rammp-org/space-bar-push-assist/cad/blender/renders/02_side.png

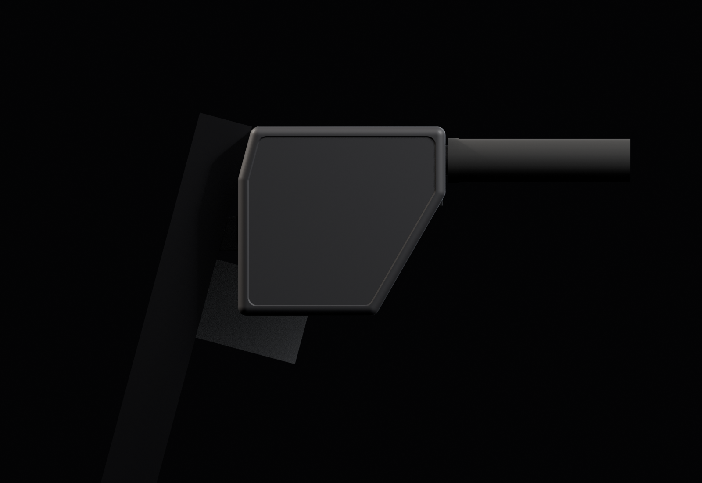
cad/blender/renders/02_side.png
