rammp-org/space-bar-push-assist/cad/blender/renders/03_handle_closeup.png

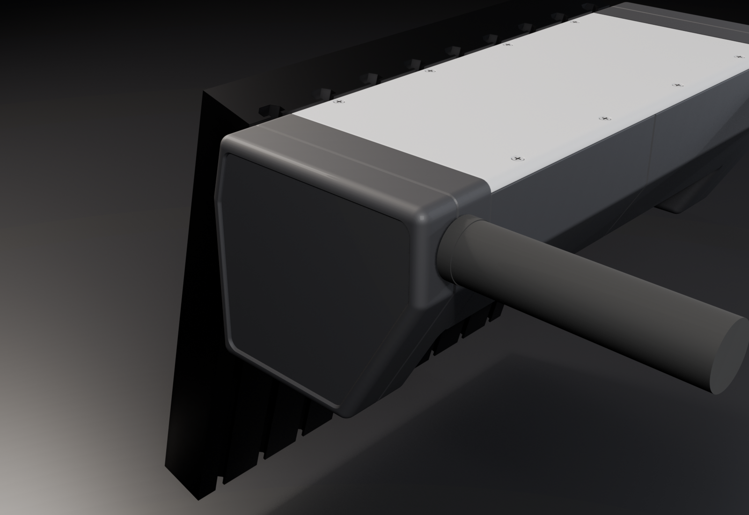
cad/blender/renders/03_handle_closeup.png
