rammp-org/space-bar-push-assist/cad/blender/renders/04_top.png

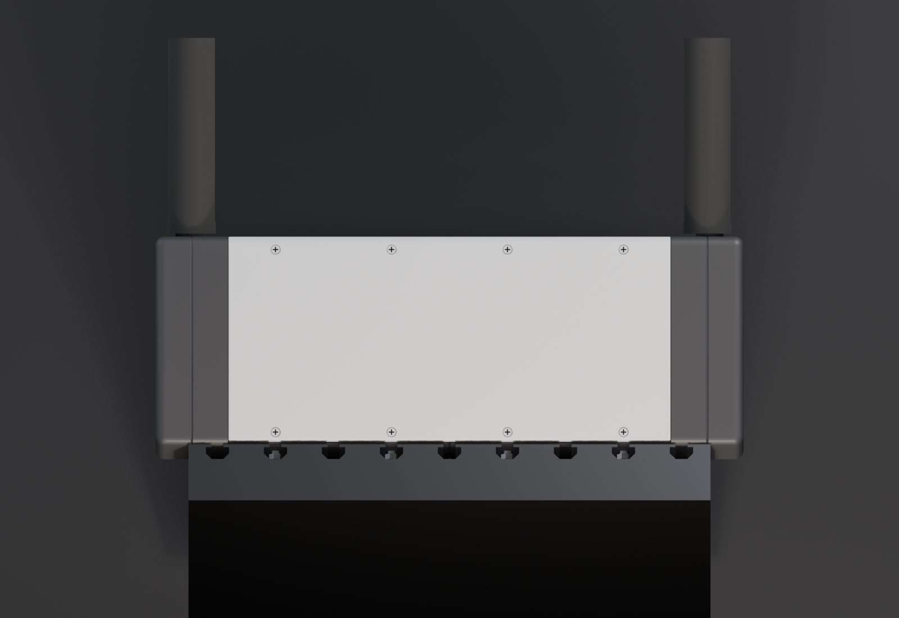
cad/blender/renders/04_top.png
