rammp-org/space-bar-push-assist/cad/blender/renders/05_exploded.png

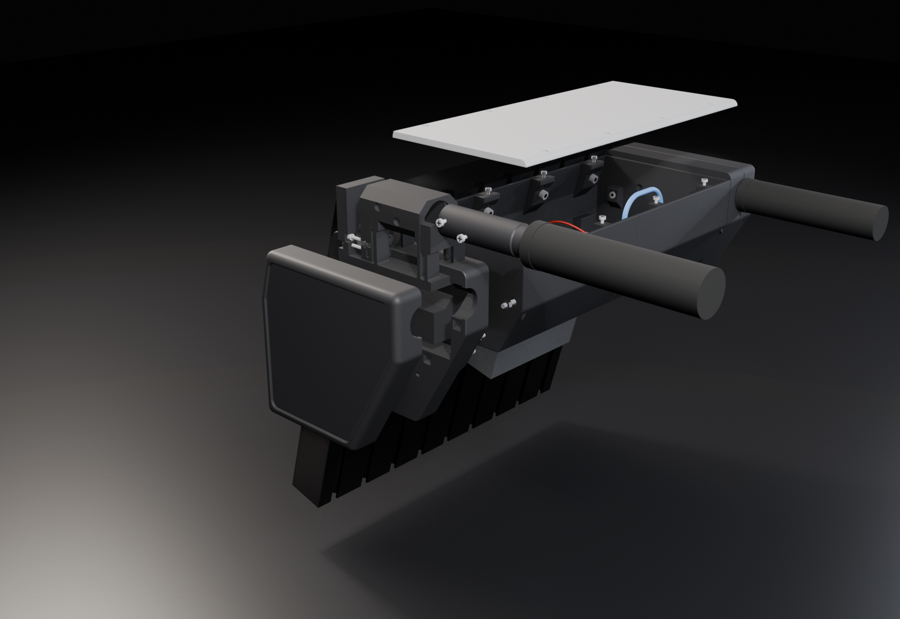
cad/blender/renders/05_exploded.png
