rammp-org/space-bar-push-assist/cad/blender/renders/06_internals.png

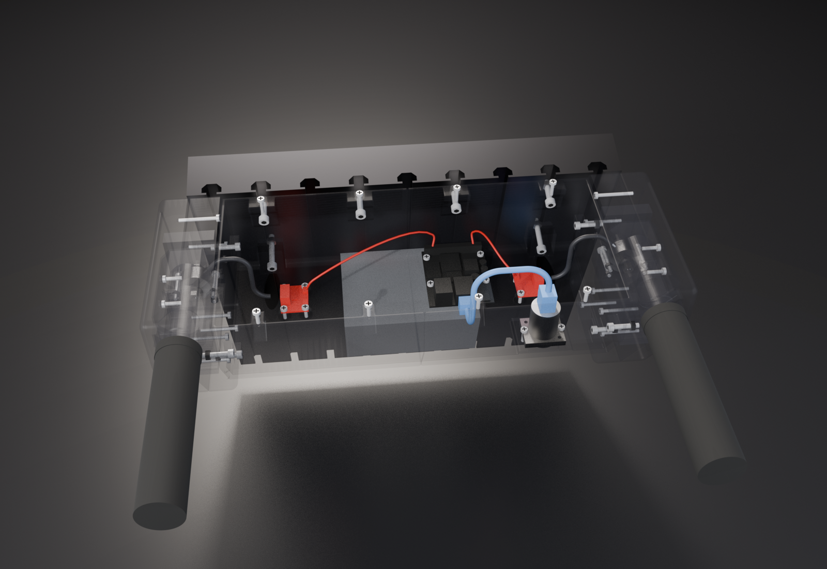
cad/blender/renders/06_internals.png
