rammp-org/space-bar-push-assist/cad/blender/renders/07_lead_side.png

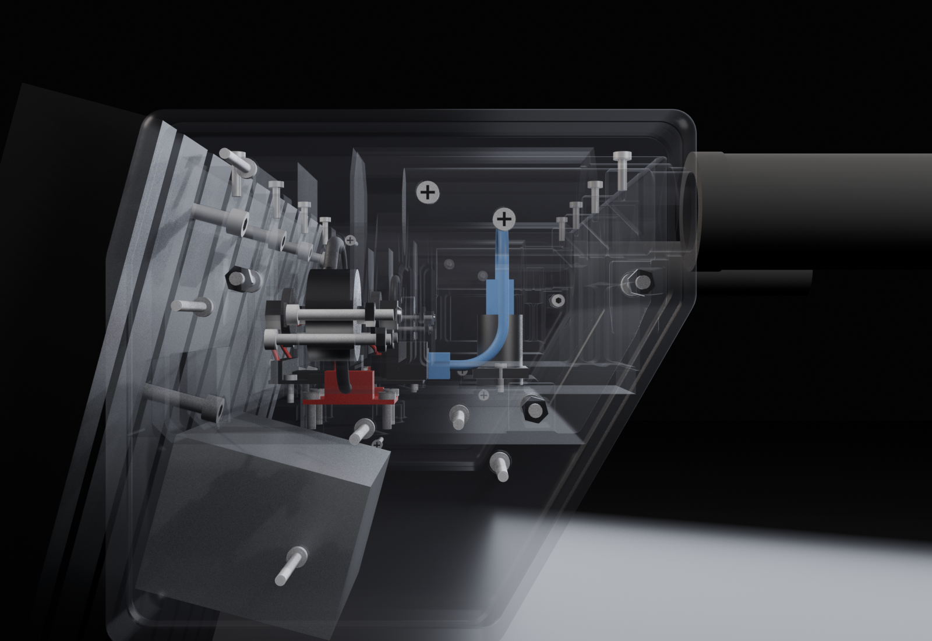
cad/blender/renders/07_lead_side.png
