rammp-org/space-bar-push-assist/cad/profile/profile.png

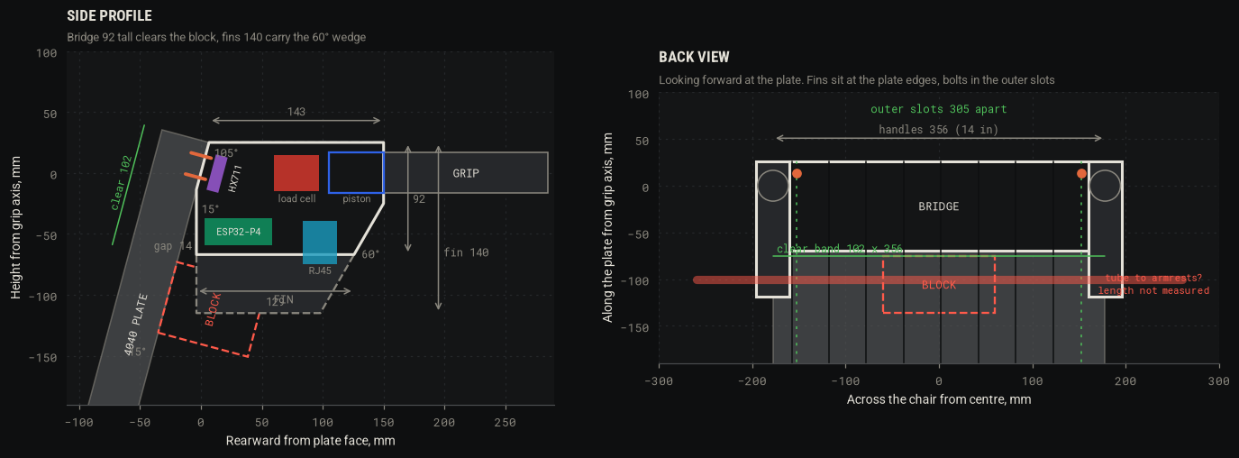
cad/profile/profile.png
