rammp-org/space-bar-push-assist/cad/review/a1/r_left_fin_outboard.png

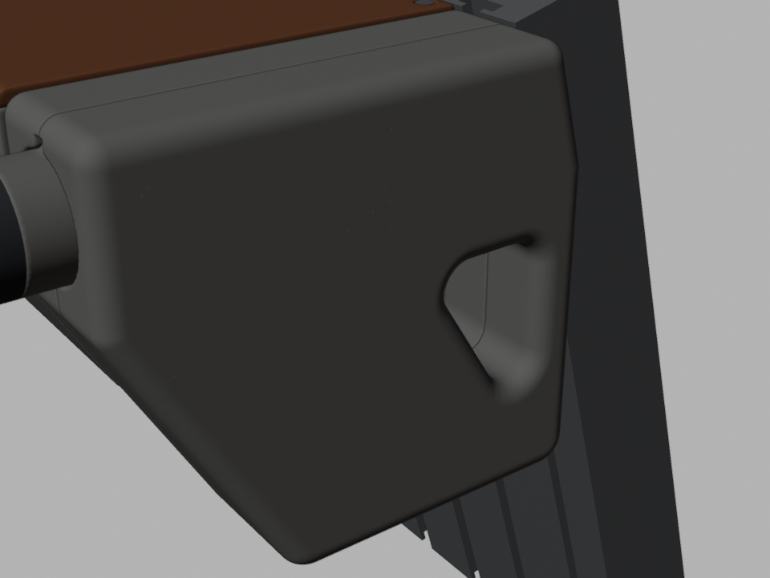
cad/review/a1/r_left_fin_outboard.png
