rammp-org/space-bar-push-assist/cad/review/a1/sec_x125_tray.png

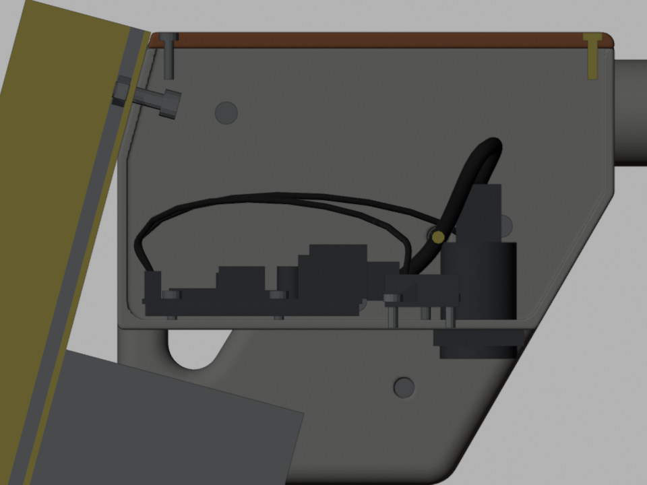
cad/review/a1/sec_x125_tray.png
