rammp-org/space-bar-push-assist/cad/review/a1/sec_x177_head.png

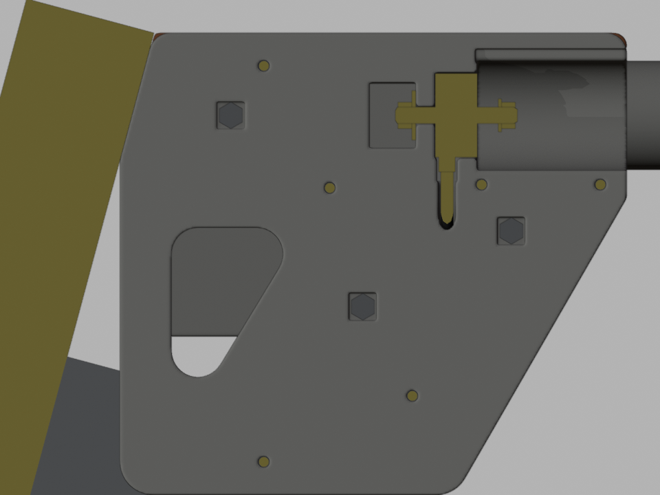
cad/review/a1/sec_x177_head.png
