rammp-org/space-bar-push-assist/cad/review/a2/r_lip_face_R.png

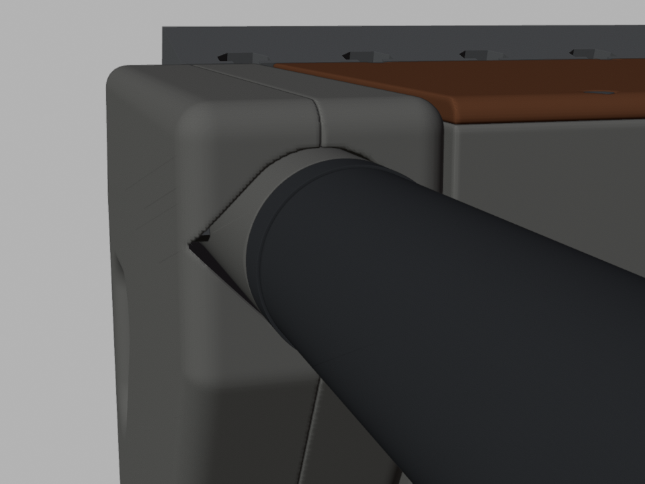
cad/review/a2/r_lip_face_R.png
