rammp-org/space-bar-push-assist/cad/review/a3/sec_x169_post.png

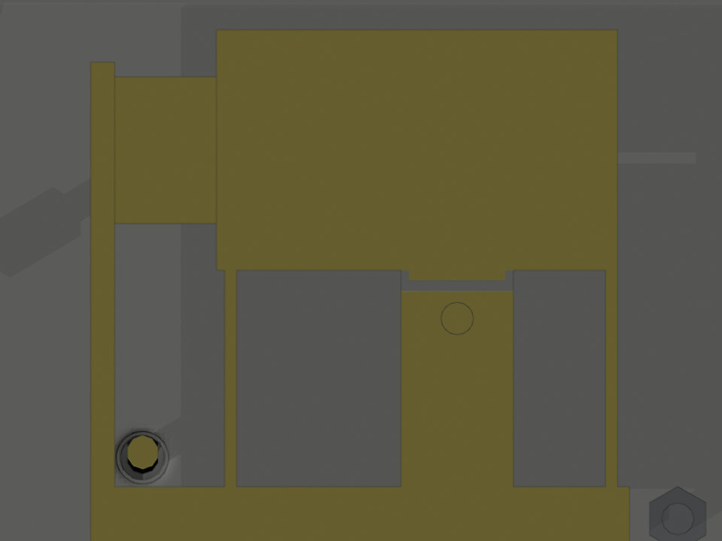
cad/review/a3/sec_x169_post.png
