rammp-org/space-bar-push-assist/cad/review/a3/sec_x177.8_head.png

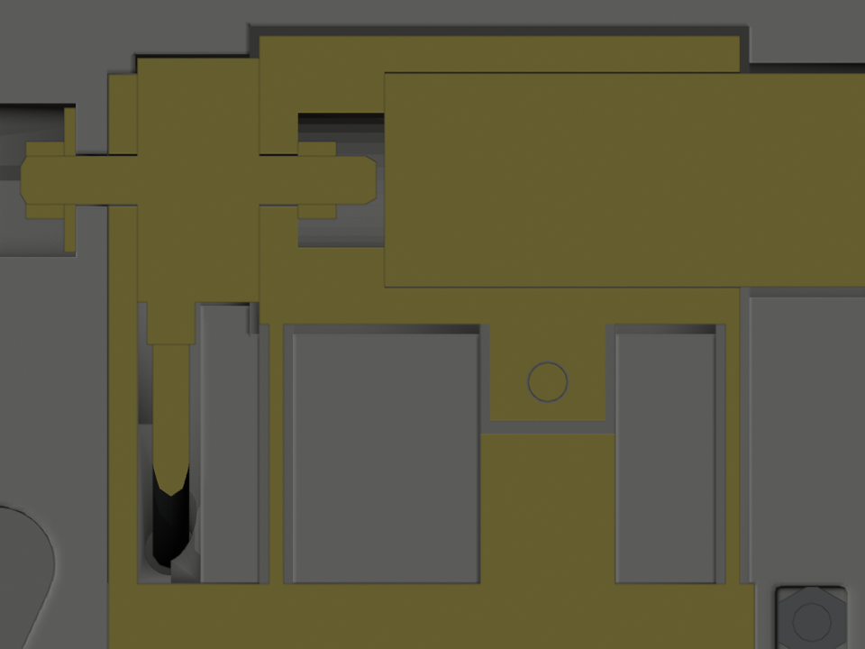
cad/review/a3/sec_x177.8_head.png
