rammp-org/space-bar-push-assist/cad/review/a4_designer/cartridge_R_z013.4_cantilever.png

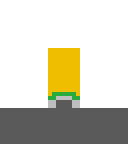
cad/review/a4_designer/cartridge_R_z013.4_cantilever.png
