rammp-org/space-bar-push-assist/cad/review/a4_designer/fin_R_outboard_z018.0_bridge.png

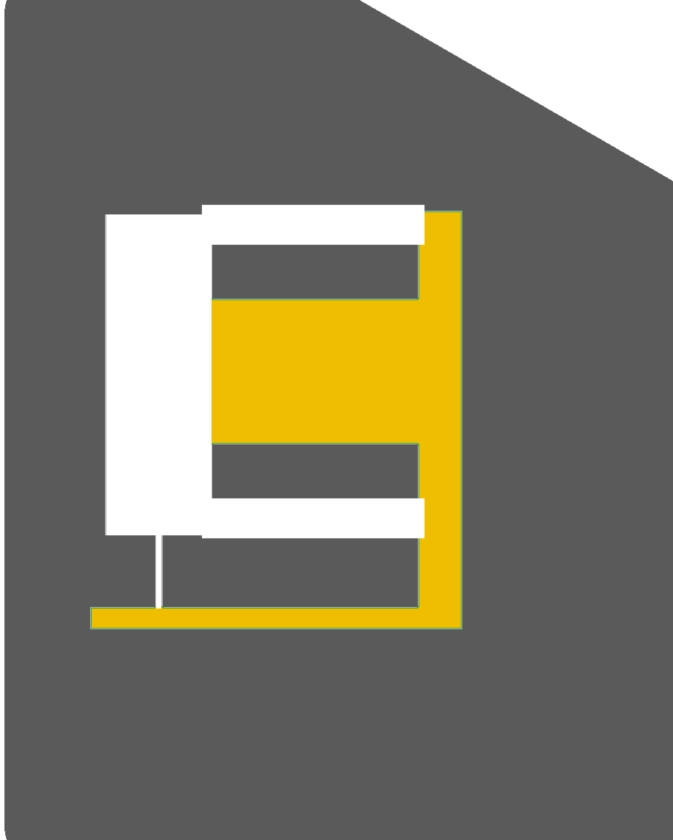
cad/review/a4_designer/fin_R_outboard_z018.0_bridge.png
