rammp-org/space-bar-push-assist/cad/review/a5_designer/fin_R_inboard_z018.0_bridge.png

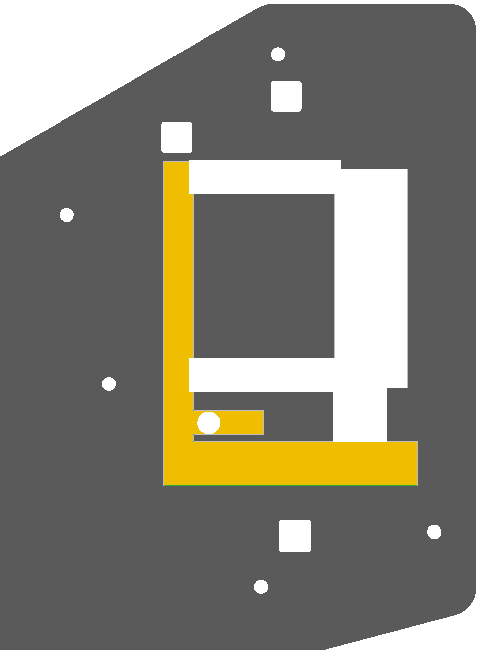
cad/review/a5_designer/fin_R_inboard_z018.0_bridge.png
