rammp-org/space-bar-push-assist/cad/review/a5_designer/fin_R_inboard_z019.0_cantilever.png

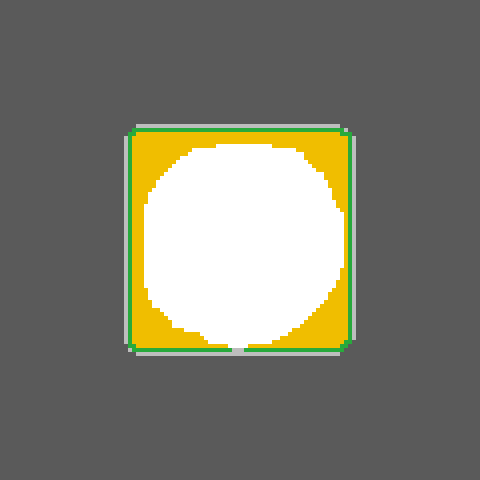
cad/review/a5_designer/fin_R_inboard_z019.0_cantilever.png
