rammp-org/space-bar-push-assist/cad/BOM.md

# Bill of materials

Generated from `cad/blender/manifest.json` by `cad/blender/gen_bom.py`; do not edit by hand.

## Fasteners

| Part | Qty | Model objects | Use |
|---|---|---|---|
| M3 x 10 pan self-tapping | 12 | `FST_Board_screw_0` `FST_Board_screw_1` `FST_Board_screw_10` `FST_Board_screw_11` `FST_Board_screw_2` `FST_Board_screw_3` `FST_Board_screw_4` `FST_Board_screw_5` `FST_Board_screw_6` `FST_Board_screw_7` `FST_Board_screw_8` `FST_Board_screw_9` | ESP32 onto its 6 mm printed standoffs (printed pilots); the two Qwiic Scale amps onto 6 mm drill-to-fit pads (drill the Ø2.5 pilots through the board's holes) |
| M3 x 12 pan self-tapping | 4 | `FST_Cover_screw_L0` `FST_Cover_screw_L2` `FST_Cover_screw_R0` `FST_Cover_screw_R2` | The one cover onto both trays (land boss tops at the front, rear-wall bosses at the rear); it joins the halves |
| M3 x 10 pan self-tapping | 4 | `FST_Cover_screw_L1` `FST_Cover_screw_L3` `FST_Cover_screw_R1` `FST_Cover_screw_R3` | The one cover onto both trays (land boss tops at the front, rear-wall bosses at the rear); it joins the halves |
| M4 x 12 socket head cap (ISO 4762) | 2 | `FST_Jack_lip_screw_a` `FST_Jack_lip_screw_b` | Bench tool: through the cradle's side walls behind the block (the pull reaction) |
| M5 x 35 socket head cap (ISO 4762) | 1 | `FST_Jack_screw` | Bench tool: the cradle's jack, on the grip axis (one set for both cartridges); its head floats 9 mm behind the upright (room for the jack nut and the mass hanger in the known-mass check) |
| M3 x 30 pan self-tapping | 12 | `FST_M3_screw_L0` `FST_M3_screw_L1` `FST_M3_screw_L2` `FST_M3_screw_L3` `FST_M3_screw_L4` `FST_M3_screw_L5` `FST_M3_screw_R0` `FST_M3_screw_R1` `FST_M3_screw_R2` `FST_M3_screw_R3` `FST_M3_screw_R4` `FST_M3_screw_R5` | Fin halves together, from the inboard face into pilots in the outboard half |
| M4 x 20 socket head cap (ISO 4762) | 6 | `FST_M4_screw_L0` `FST_M4_screw_L1` `FST_M4_screw_L2` `FST_M4_screw_R0` `FST_M4_screw_R1` `FST_M4_screw_R2` | Fin to tray end wall, from inside the tray into the fin's captive nuts |
| M5 x 20 socket head cap (ISO 4762) | 4 | `FST_M5_bolt_0` `FST_M5_bolt_1` `FST_M5_bolt_2` `FST_M5_bolt_3` | Unit to the chair plate, into 40-series drop-in T-nuts |
| M5 x 30 socket head cap (ISO 4762) | 2 | `FST_M5_bolt_4` `FST_M5_bolt_5` | Unit to the chair plate, into 40-series drop-in T-nuts |
| M3 x 12 pan self-tapping | 4 | `FST_Piston_screw_L0` `FST_Piston_screw_L1` `FST_Piston_screw_R0` `FST_Piston_screw_R1` | Piston plug into the cartridge socket, from the top link's outboard face |
| M3 x 12 pan self-tapping | 2 | `FST_RJ45_screw_0` `FST_RJ45_screw_1` | RJ45 coupler flange onto its pad in tray L, from above |
| M3 x 30 socket head cap (ISO 4762) | 4 | `FST_Stop_screw_pull_L_in` `FST_Stop_screw_pull_L_out` `FST_Stop_screw_pull_R_in` `FST_Stop_screw_pull_R_out` | Pull overload stop (two per cartridge): from the front through the block into its nut; its head's underside meets the block's front counterbore floor; set per cell in the cradle (README) |
| M3 x 25 socket head cap (ISO 4762) | 4 | `FST_Stop_screw_push_L_in` `FST_Stop_screw_push_L_out` `FST_Stop_screw_push_R_in` `FST_Stop_screw_push_R_out` | Push overload stop, on the cell axis (two per cartridge): goes in sideways with its nut on (after the cell); its head's top face meets a counterbore floor in the block; set per cell in the cradle (README) |
| M4 hex nut | 2 | `FST_Jack_lip_nut_a` `FST_Jack_lip_nut_b` | Bench tool: in pockets on the cradle side walls' inner faces |
| M5 hex nut | 1 | `FST_Jack_nut` | Bench tool: in the cradle's rear upright |
| M5 hex nut (glued on the jack screw tip) | 1 | `FST_Jack_swivel_nut` | Bench tool: superglued on the jack screw's tip, in the setting plug's T-slot |
| M4 hex nut | 6 | `FST_M4_nut_L0` `FST_M4_nut_L1` `FST_M4_nut_L2` `FST_M4_nut_R0` `FST_M4_nut_R1` `FST_M4_nut_R2` | Fin-to-tray nuts, in slots on the inboard half's split face |
| M3 hex nut | 4 | `FST_Stop_nut_pull_L_in` `FST_Stop_nut_pull_L_out` `FST_Stop_nut_pull_R_in` `FST_Stop_nut_pull_R_out` | Pull stop nut, in a slot in the side of the link's drop |
| M3 hex nut | 4 | `FST_Stop_nut_push_L_in` `FST_Stop_nut_push_L_out` `FST_Stop_nut_push_R_in` `FST_Stop_nut_push_R_out` | Push stop nut, in a slot in the side of the link's drop |
| M5 drop-in T-nut, 40 series | 6 | `FST_T-nut_0` `FST_T-nut_1` `FST_T-nut_2` `FST_T-nut_3` `FST_T-nut_4` `FST_T-nut_5` | In the chair plate's slots |

## Load-cell hardware (on the cell studs)

| Part | Qty |
|---|---|
| M5 hex nut (front: on the front stud, on the printed Ø15 washer in the block's front counterbore; 8 mm nut-driver) | 2 |
| M5 hex nut (rear: on the rear stud, on the printed Ø13 washer in the drop's bore; 8 mm nut-driver on the 150 mm extension along the cell axis, between the leaf strips and under the catch saddle, from the cartridge's rear end) | 2 |

Both cell nuts are finger-tight on the bare 8 mm nut-driver bit (about 0.1-0.2 N.m), settled overnight on the bench, re-snugged, then locked with a dab of hot glue, all before the stops are set. The washers are printed (below), 2.4 mm thick: each bridges the 5.5 mm stud slot under its nut (11 MPa at 1.2 x FS pull, row a7R washer); no bought washers.

## Load cell: 20 kg JHD puck (chosen by Alex, 2026-10-27)

**Two 20 kg JHD tension/compression pucks** (Ø25.4 x 12.7 body, M5 studs 12.15 long). The unit is not meant for hard shoves: with the stops at 1.2 x FS a 600 N shove would reach 1.44-1.92 x FS, so keep pushes gentle. The 50 kg puck (same body and studs) drops in with no CAD change if that ever changes. Note the cell's rated output (mV/V) from its label or calibration sheet: the firmware's scale needs it (README).

## Amplifiers: SparkFun Qwiic Scale (NAU7802, SEN-15242), no soldering iron and no blade

Two SparkFun Qwiic Scale boards (a6 review #2: the Adafruit HX711's logic header shipped loose). Nothing on them needs an iron or a small screwdriver: the cell's four wires go into a push-lever spring terminal (press the lever with a fingertip or the tip of a hex key, push the stripped wire in, let go), and the logic side is a Qwiic (JST SH) socket. Per board, one Qwiic-to-female-socket cable (they come long; cut to length) (SparkFun PRT-14988 or Adafruit 4397) to the ESP32 header. The NAU7802 has a fixed I2C address, so the two boards go on the ESP32-P4's two I2C ports. Four Ø3.3 holes on a 17.8 x 25.4 mm pattern (measured on a board). Each amp sits on four 6 mm drill-to-fit pads (Ø10, solid, a centre dimple, no printed pilot). Set the board on them and drill the Ø2.5 pilots through its holes, 9 mm deep; a hole up to 1.5 mm off the modelled pattern still leaves 1.5 mm of wall round the pilot. Then four of the kit's M3 x 10 self-tappers per board.

**ESP32 header: measure before ordering the cables.** The Qwiic-to-female-socket cables need male header pins on the Waveshare ESP32-P4 board's GPIO header. That the board ships with them fitted is not verified; if it does not, buy Qwiic-to-male-pin cables (or a Qwiic breakout) instead, still no soldering on our side. The ESP32's own four standoffs keep printed pilots (its hole pattern is from Waveshare's drawing).

## Bench tools (one set, for setting the stops)

The cradle and setting plug (printed, below), an M5 x 35 jack screw with two M5 nuts and two M4 x 12 lip screws with nuts (in the fastener table), the printed mass hanger, the unit's ESP32-P4 and one amp running `firmware/` as the force readout, a 2.5 mm and a 4 mm hex key, a known mass (5 or 10 kg, e.g. a bag or a water can) on a cord, and a hook or a door handle to hang the cradle from by its eye.

## Printed parts

PLA, as for the rest of the unit. The two cartridges and the four washers carry the cell's clamp and the flexure leaves: print them in PETG instead (same files, same orientation, no other change) if the chair will be parked in a hot car or in sun, because PLA softens near 55 C (`cad/calc/head_calc.txt`).

Estimates from `cad check` (cad/review/cadcheck_a8.json).

| Part | Qty | Print orientation | Supports | Est. g | Est. h |
|---|---|---|---|---|---|
| cartridge_L | 1 | on its side, inboard face down (leaves bend in the layer plane) | no | 80.4 | 1.6 |
| cartridge_R | 1 | on its side, inboard face down (leaves bend in the layer plane) | no | 80.4 | 1.6 |
| cover | 1 | flat, underside down | no | 127.6 | 2.48 |
| cradle | 1 | base down, open top up | no | 139.7 | 2.71 |
| fin_L_inboard | 1 | split face down | no | 124.8 | 2.43 |
| fin_L_outboard | 1 | split face down | no | 116.6 | 2.28 |
| fin_R_inboard | 1 | split face down | no | 124.8 | 2.43 |
| fin_R_outboard | 1 | split face down | no | 116.6 | 2.28 |
| mass_hanger | 1 | flat, keyhole slot vertical | no | 3.4 | 0.16 |
| piston_L | 1 | on its side, D-flat (inboard) down | no | 47.6 | 0.99 |
| piston_R | 1 | on its side, D-flat (inboard) down | no | 47.6 | 0.99 |
| setting_plug | 1 | on its side, D-flat down (T-slot up) | no | 15.7 | 0.39 |
| tray_L | 1 | floor down, open top up | no | 148.7 | 2.88 |
| tray_R | 1 | floor down, open top up | no | 147.4 | 2.85 |
| washer_front_L | 1 | flat | no | 0.5 | 0.11 |
| washer_front_R | 1 | flat | no | 0.5 | 0.11 |
| washer_rear_L | 1 | flat | no | 0.3 | 0.11 |
| washer_rear_R | 1 | flat | no | 0.3 | 0.11 |

## Purchased

| Part | Source |
|---|---|
| amp_L | SparkFun Qwiic Scale, NAU7802 24-bit load-cell ADC, SEN-15242 (spring terminal for the cell, Qwiic socket for the logic: no soldering), stand-in built by build_concept.amp_board() |
| amp_R | SparkFun Qwiic Scale, NAU7802 24-bit load-cell ADC, SEN-15242 (spring terminal for the cell, Qwiic socket for the logic: no soldering), stand-in built by build_concept.amp_board() |
| corpus_back_plate | Permobil Corpus back plate stand-in from Alex's measurements |
| esp32_p4 | Waveshare ESP32-P4 WiFi6 PoE, cad/blender/parts/esp32_p4.stl (its 3.75 mm spacers flattened; sits on 6 mm printed standoffs) |
| grip_L | lock-on MTB grip, cad/blender/parts/mtb_grip.stl |
| grip_R | lock-on MTB grip, cad/blender/parts/mtb_grip.stl |
| load_cell_L | JHD T/C puck, 50 kg recommended (20 kg fallback, same body; BOM), M5 studs 12.15 long, 12.7 between faces, cad/blender/parts/load_cell.stl |
| load_cell_R | JHD T/C puck, 50 kg recommended (20 kg fallback, same body; BOM), M5 studs 12.15 long, 12.7 between faces, cad/blender/parts/load_cell.stl |
| patch_plug_board | RJ45 plug stand-in |
| patch_plug_coupler | RJ45 plug stand-in |
| rj45_coupler | panel RJ45 coupler, cad/blender/parts/rj45_coupler.stl |
