rammp-org/space-bar-push-assist/cad/blender/parts/mtb_grip.stl

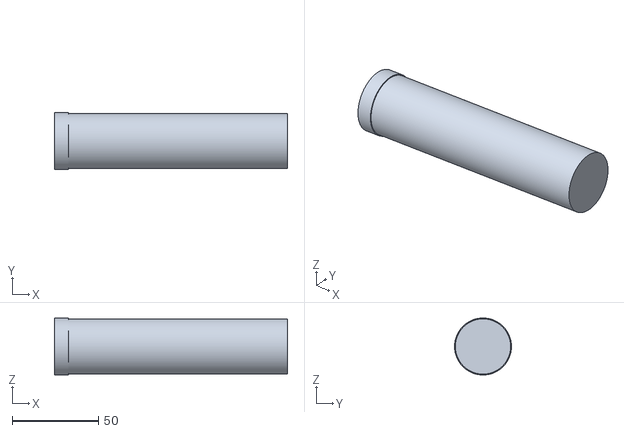
[picture p27: CAD file, 2026-10-24]
cad/blender/parts/mtb_grip.stl
135.0 x 33.0 x 33.0
