rammp-org/space-bar-push-assist/cad/blender/parts/esp32_p4.stl

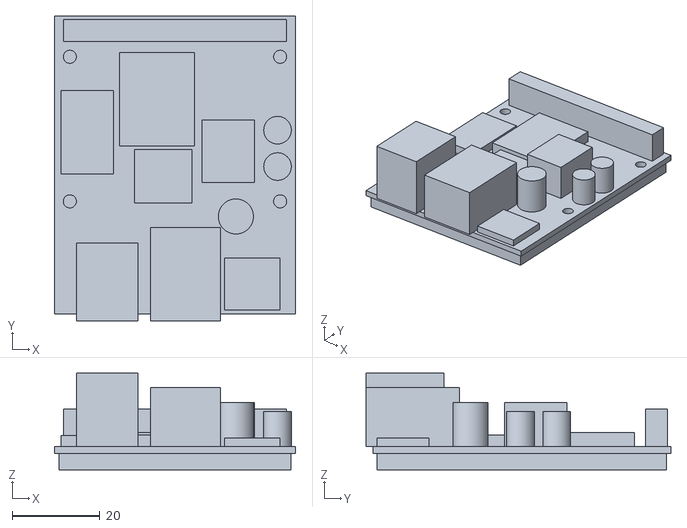
[picture p28: CAD file, 2026-10-24]
cad/blender/parts/esp32_p4.stl
55.0 x 69.5 x 22.1
