rammp-org/space-bar-push-assist/cad/blender/parts/hx711.stl

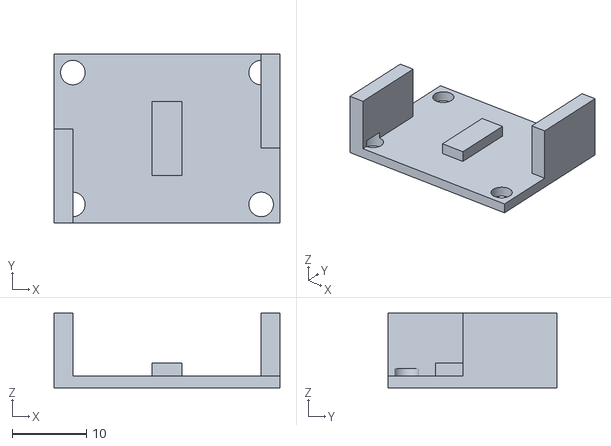
[picture p29: CAD file, 2026-10-24]
cad/blender/parts/hx711.stl
30.5 x 22.9 x 10.1
