rammp-org/space-bar-push-assist/cad/blender/parts/load_cell.stl

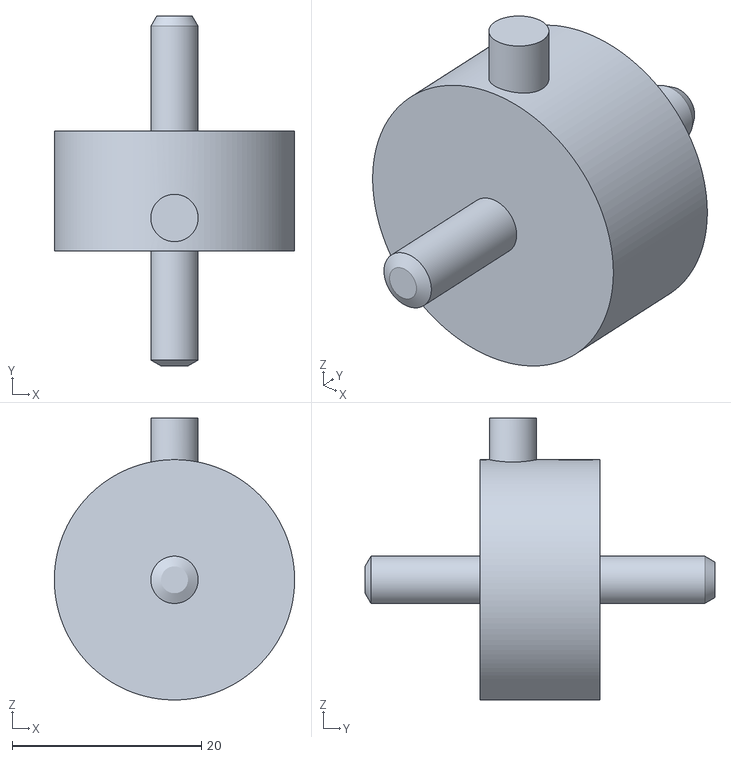
[picture p30: CAD file, 2026-10-24]
cad/blender/parts/load_cell.stl
25.4 x 37.0 x 29.8
