rammp-org/space-bar-push-assist/cad/blender/parts/rj45_coupler.stl

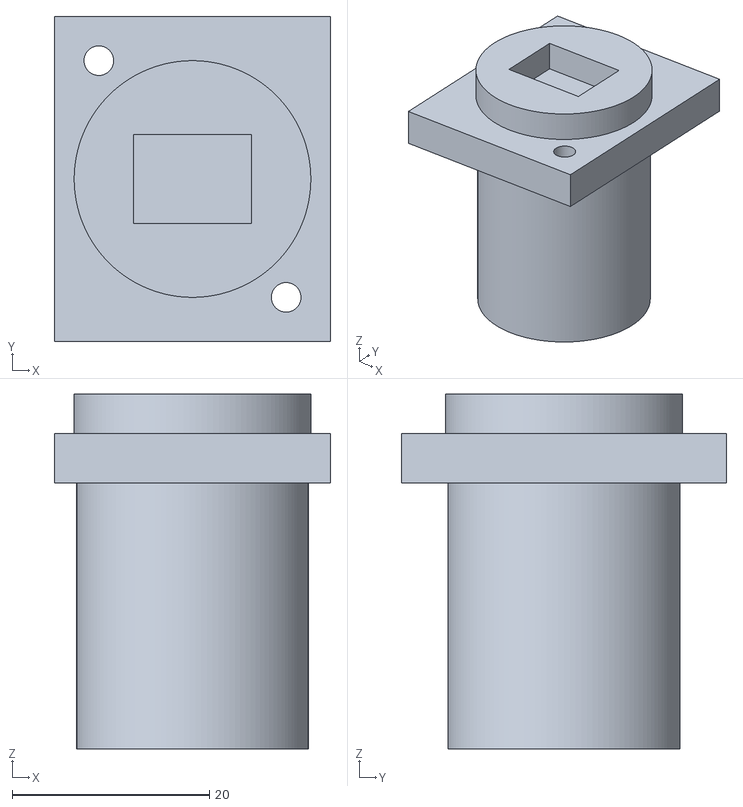
[picture p31: CAD file, 2026-10-24]
cad/blender/parts/rj45_coupler.stl
28.0 x 33.0 x 36.0
