rammp-org/space-bar-push-assist/cad/review/a1/printcheck/fin_L_inboard_printcheck.png

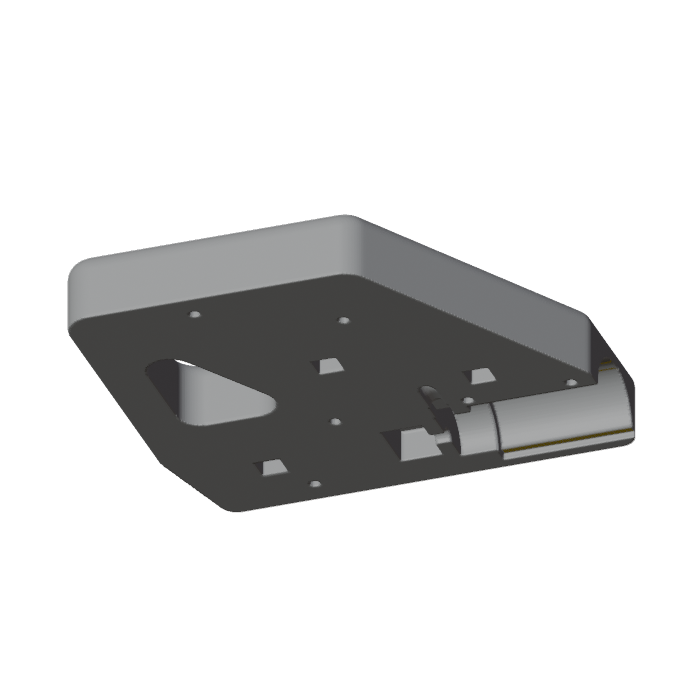
cad/review/a1/printcheck/fin_L_inboard_printcheck.png
