rammp-org/space-bar-push-assist/cad/review/a1/printcheck/fin_L_outboard_z002.2_cantilever.png

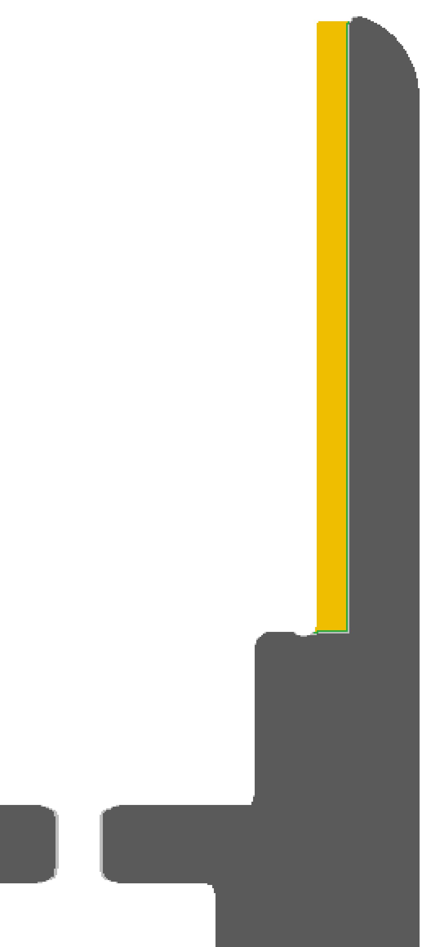
cad/review/a1/printcheck/fin_L_outboard_z002.2_cantilever.png
