rammp-org/space-bar-push-assist/cad/review/a1/printcheck/piston_L_printcheck.png

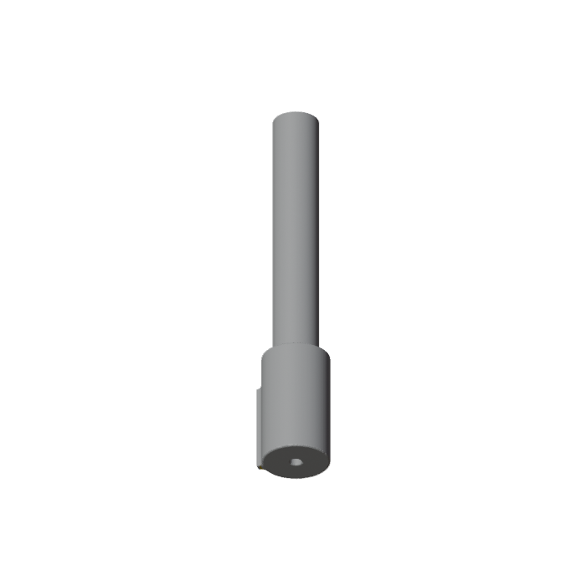
cad/review/a1/printcheck/piston_L_printcheck.png
