rammp-org/space-bar-push-assist/cad/review/a1/printcheck/piston_L_z000.4_cantilever.png

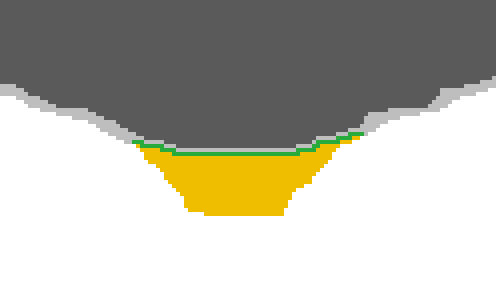
cad/review/a1/printcheck/piston_L_z000.4_cantilever.png
