rammp-org/space-bar-push-assist/cad/review/a1/printcheck_standing/fin_L_outboard_standing_z000.2_cantilever.png

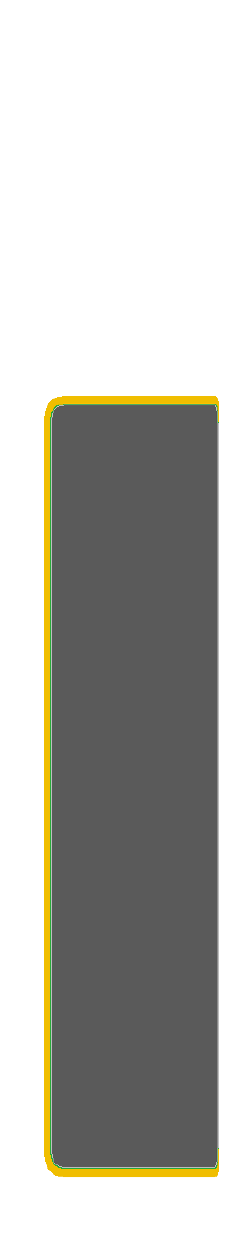
cad/review/a1/printcheck_standing/fin_L_outboard_standing_z000.2_cantilever.png
