rammp-org/space-bar-push-assist/cad/review/a1/printcheck_standing/fin_L_outboard_standing_z128.0_cantilever.png

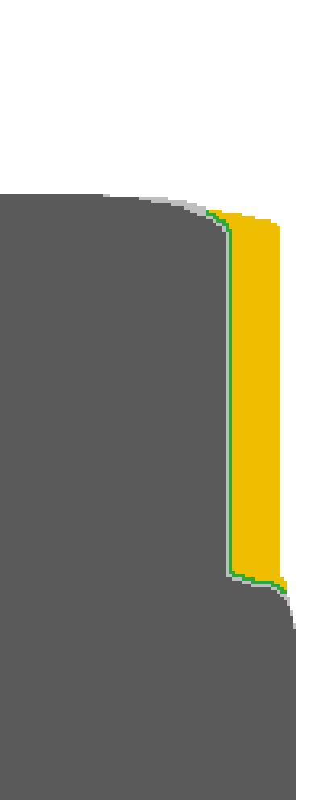
cad/review/a1/printcheck_standing/fin_L_outboard_standing_z128.0_cantilever.png
