rammp-org/space-bar-push-assist/cad/review/a1/printcheck_standing/fin_R_inboard_standing_z079.2_cantilever.png

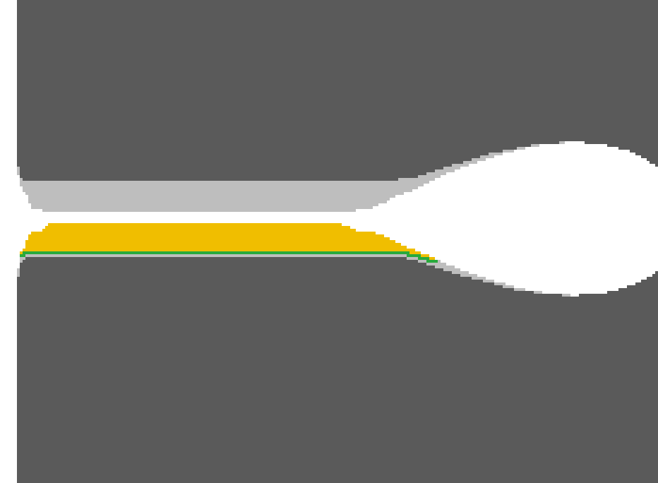
cad/review/a1/printcheck_standing/fin_R_inboard_standing_z079.2_cantilever.png
