rammp-org/space-bar-push-assist/cad/review/a2/printcheck/piston_L_printcheck.png

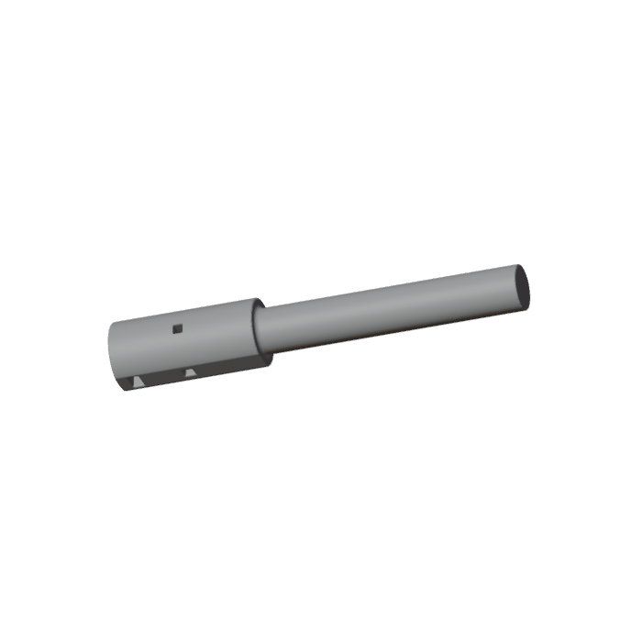
cad/review/a2/printcheck/piston_L_printcheck.png
