rammp-org/space-bar-push-assist/cad/review/a2/printcheck/piston_L_z004.2_cantilever.png

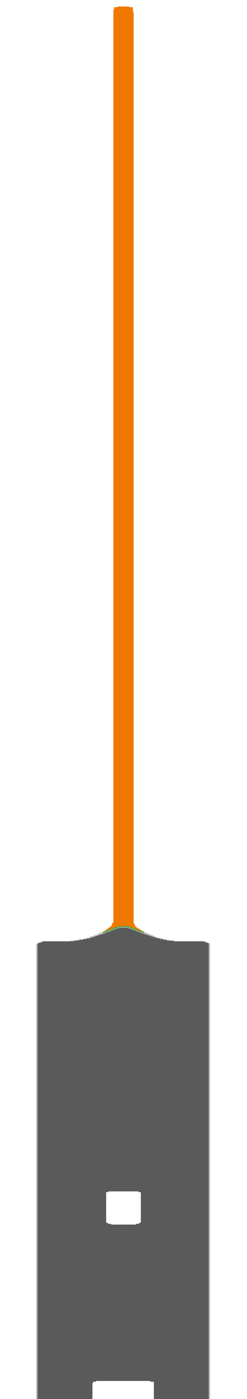
cad/review/a2/printcheck/piston_L_z004.2_cantilever.png
