rammp-org/space-bar-push-assist/cad/review/a3/printcheck/fin_L_outboard_z018.0_bridge.png

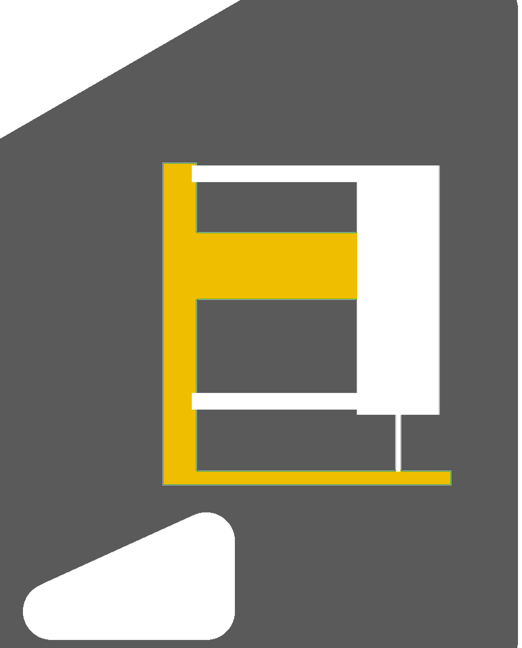
cad/review/a3/printcheck/fin_L_outboard_z018.0_bridge.png
