rammp-org/space-bar-push-assist/cad/review/a3/printcheck/fin_R_inboard_z018.0_bridge.png

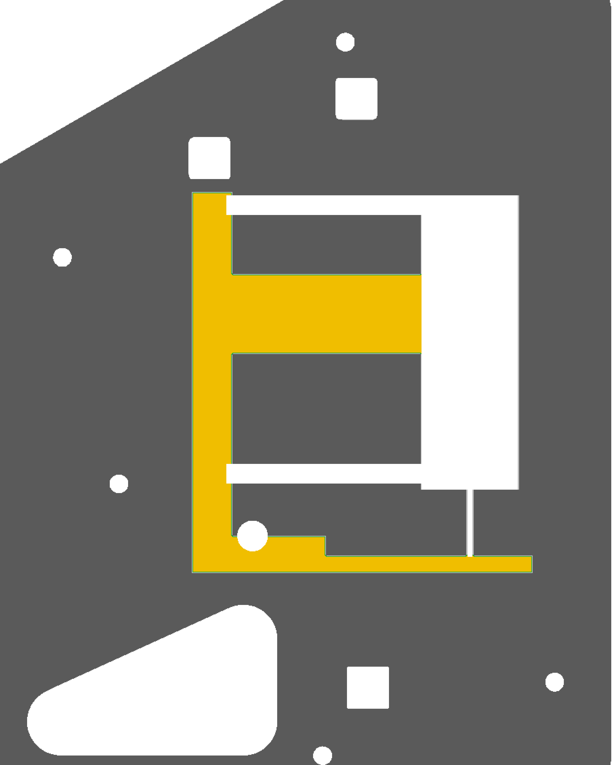
cad/review/a3/printcheck/fin_R_inboard_z018.0_bridge.png
