rammp-org/space-bar-push-assist/cad/review/a3_designer/printcheck_fin_pocket_roof_z18.png

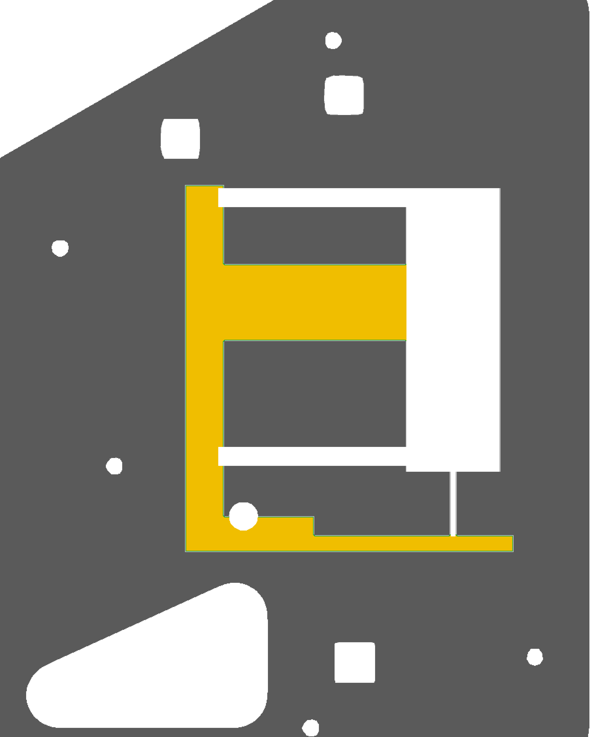
cad/review/a3_designer/printcheck_fin_pocket_roof_z18.png
