rammp-org/space-bar-push-assist/cad/review/a4/printcheck/cartridge_L_printcheck.png

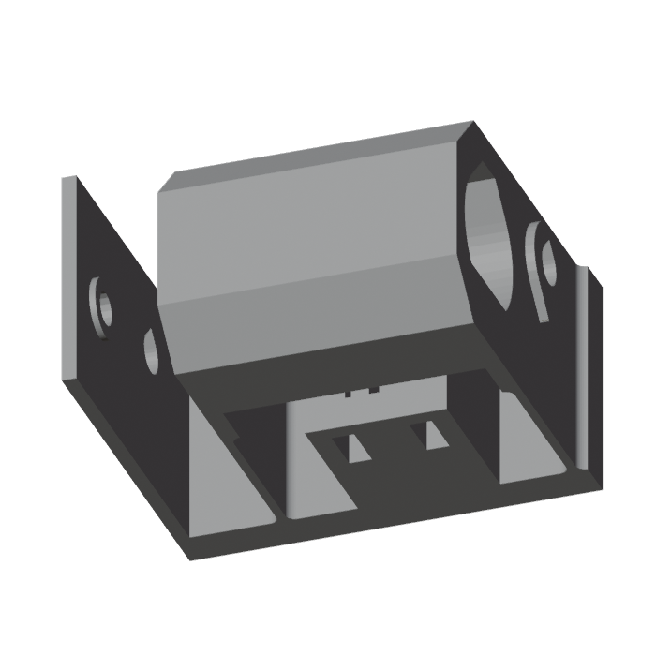
cad/review/a4/printcheck/cartridge_L_printcheck.png
