rammp-org/space-bar-push-assist/cad/review/a4/printcheck/cartridge_R_printcheck.png

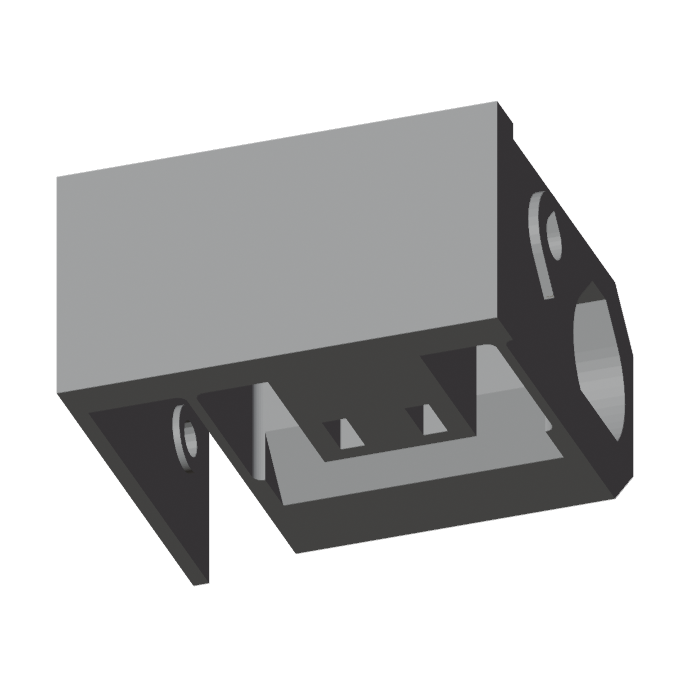
cad/review/a4/printcheck/cartridge_R_printcheck.png
