rammp-org/space-bar-push-assist/cad/review/a4/printcheck/fin_L_outboard_printcheck.png

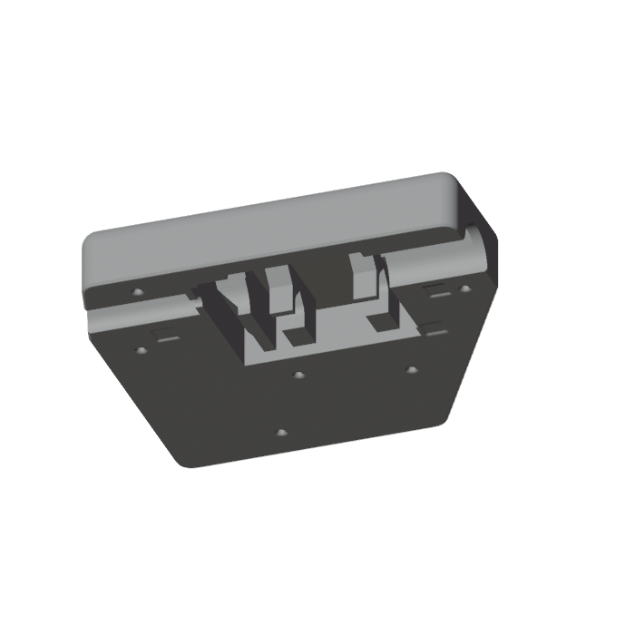
cad/review/a4/printcheck/fin_L_outboard_printcheck.png
