rammp-org/space-bar-push-assist/cad/review/a4/printcheck/fin_L_outboard_z018.0_bridge.png

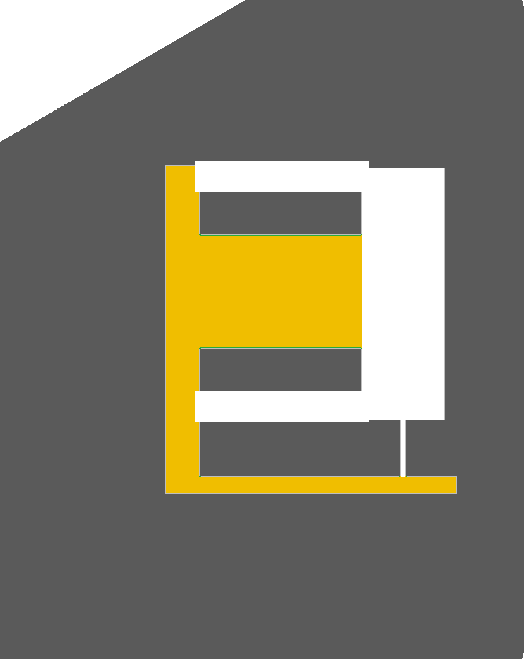
cad/review/a4/printcheck/fin_L_outboard_z018.0_bridge.png
