rammp-org/space-bar-push-assist/cad/review/a4/printcheck/fin_R_inboard_z018.0_bridge.png

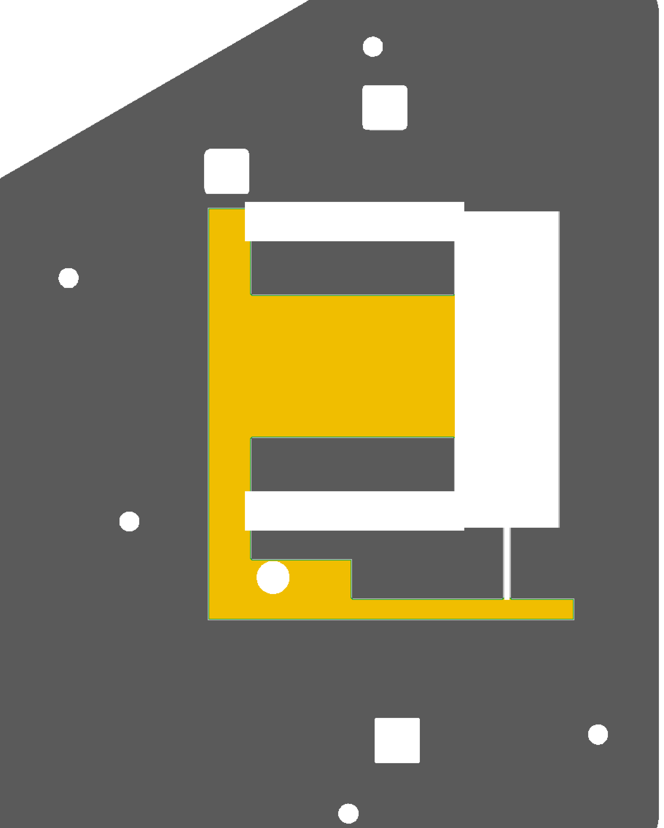
cad/review/a4/printcheck/fin_R_inboard_z018.0_bridge.png
