rammp-org/space-bar-push-assist/cad/review/a5/printcheck/fin_L_inboard_z019.0_bridge.png

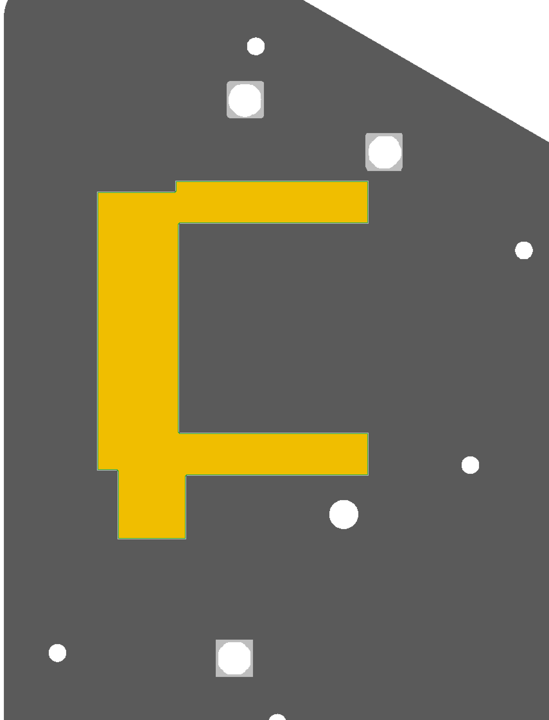
cad/review/a5/printcheck/fin_L_inboard_z019.0_bridge.png
