rammp-org/space-bar-push-assist/cad/review/a5/printcheck/fin_L_outboard_printcheck.png

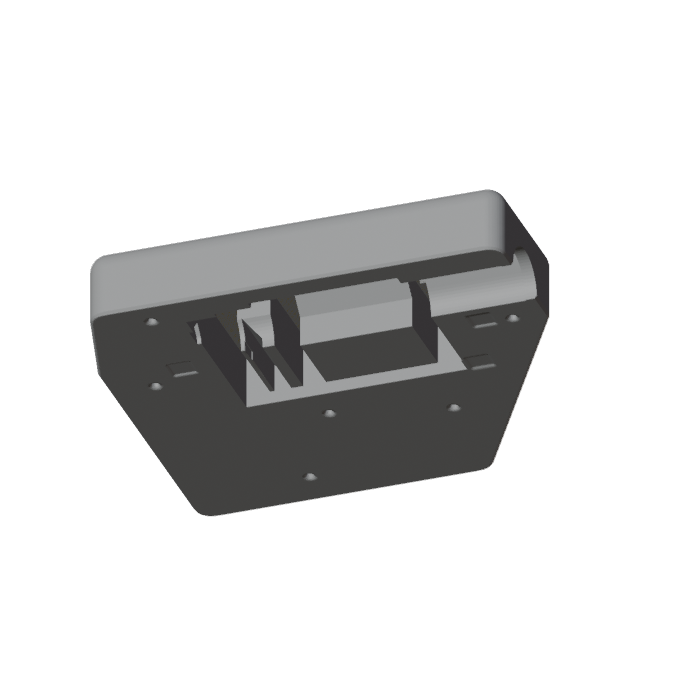
cad/review/a5/printcheck/fin_L_outboard_printcheck.png
