rammp-org/space-bar-push-assist/cad/review/a5/printcheck/fin_L_outboard_z010.6_cantilever.png

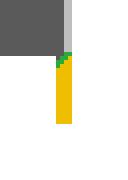
cad/review/a5/printcheck/fin_L_outboard_z010.6_cantilever.png
