rammp-org/space-bar-push-assist/cad/review/a7/printcheck/cartridge_L_printcheck.png

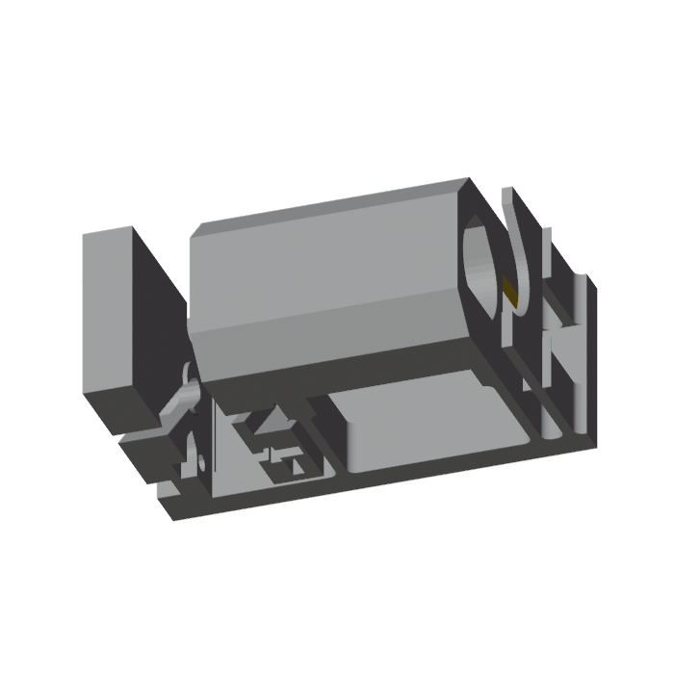
cad/review/a7/printcheck/cartridge_L_printcheck.png
