rammp-org/space-bar-push-assist/cad/review/a7/printcheck/cartridge_L_z027.4_bridge.png

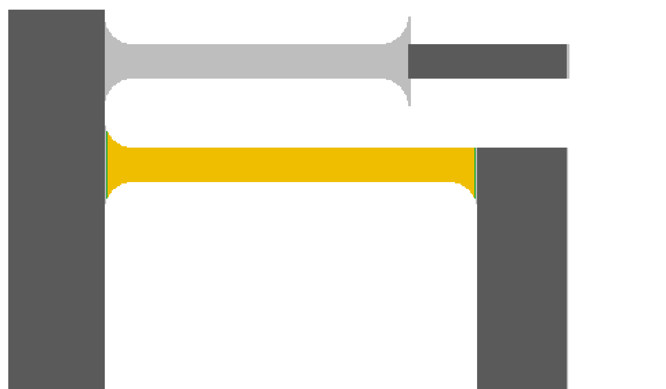
cad/review/a7/printcheck/cartridge_L_z027.4_bridge.png
