rammp-org/space-bar-push-assist/cad/review/a7/printcheck/cartridge_R_printcheck.png

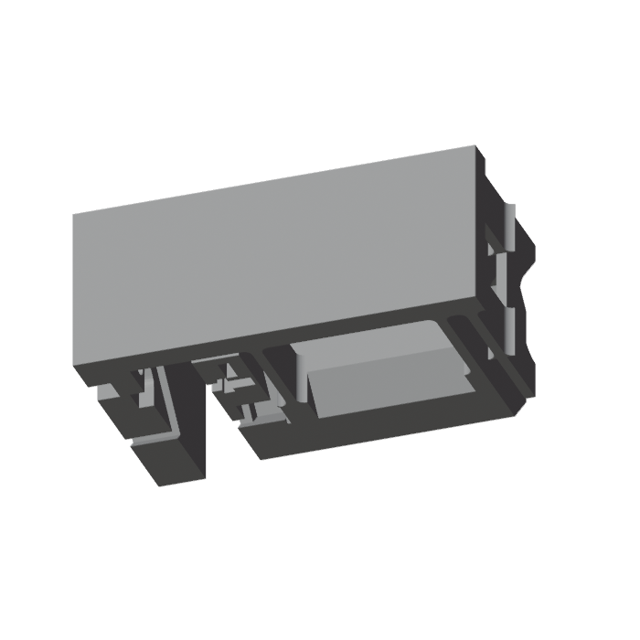
cad/review/a7/printcheck/cartridge_R_printcheck.png
