rammp-org/space-bar-push-assist/cad/review/a7/printcheck/fin_L_outboard_z020.0_bridge.png

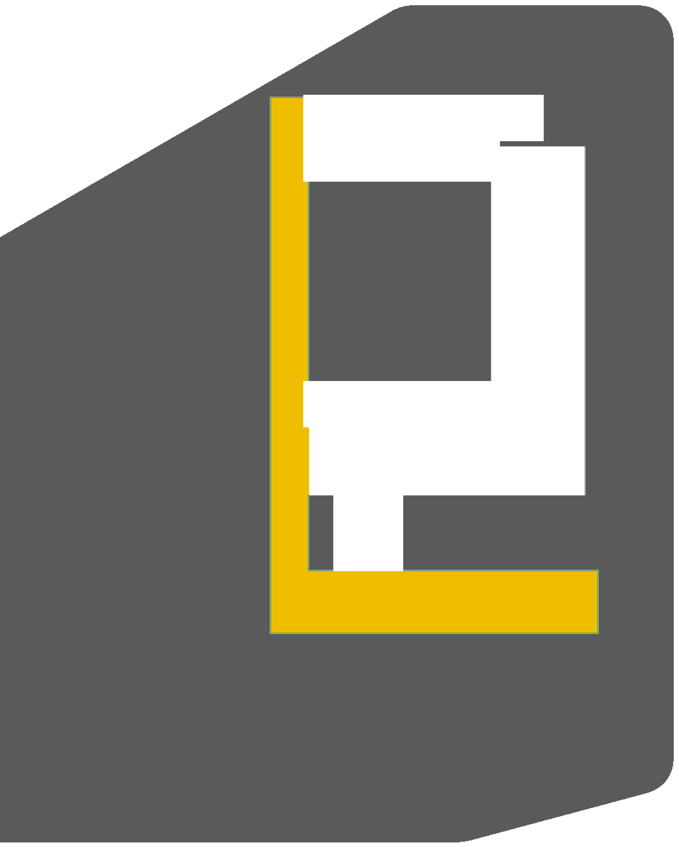
cad/review/a7/printcheck/fin_L_outboard_z020.0_bridge.png
