rammp-org/space-bar-push-assist/cad/review/a7/printcheck/fin_R_inboard_z019.0_cantilever.png

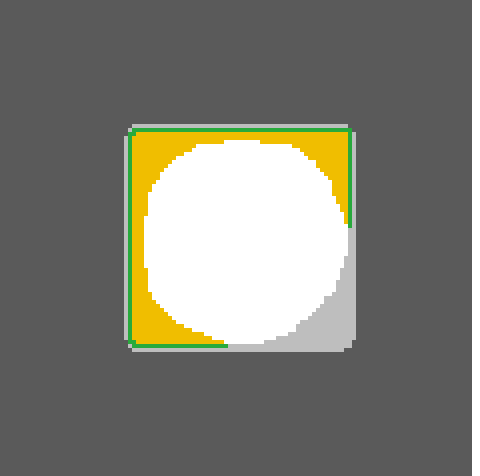
cad/review/a7/printcheck/fin_R_inboard_z019.0_cantilever.png
