rammp-org/space-bar-push-assist/cad/review/a7/printcheck/fin_R_outboard_z021.0_bridge.png

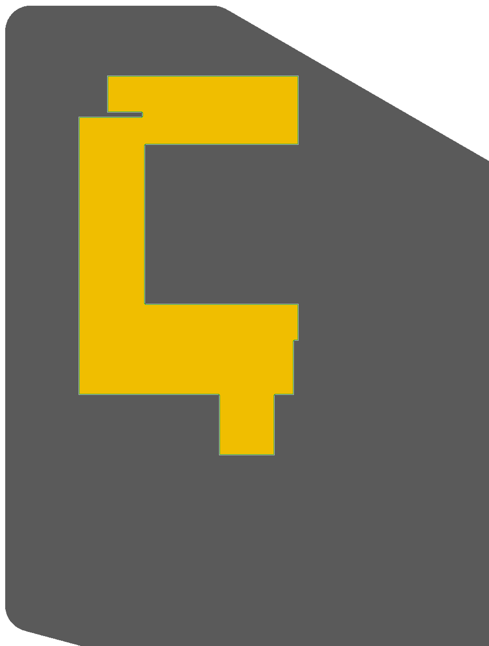
cad/review/a7/printcheck/fin_R_outboard_z021.0_bridge.png
