rammp-org/space-bar-push-assist/cad/review/a7/printcheck/tray_R_printcheck.png

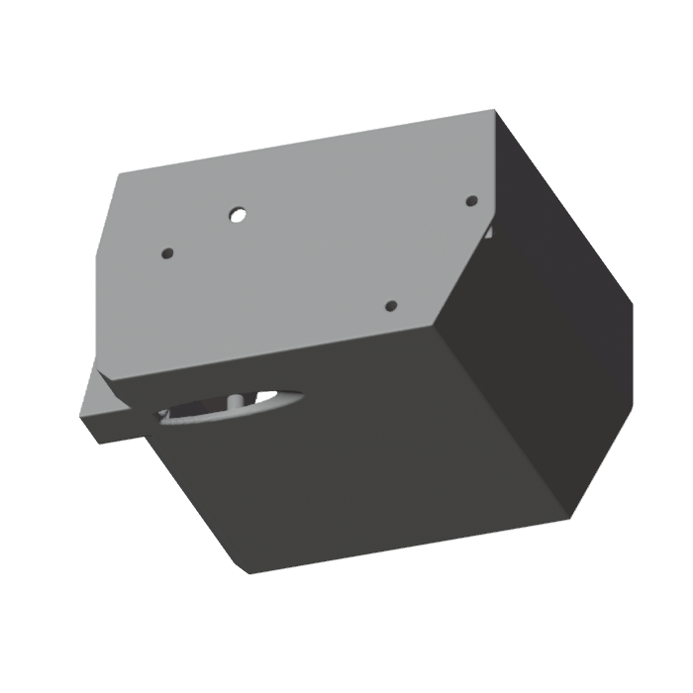
cad/review/a7/printcheck/tray_R_printcheck.png
