rammp-org/space-bar-push-assist/cad/review/a8/printcheck/cartridge_L_z027.4_bridge.png

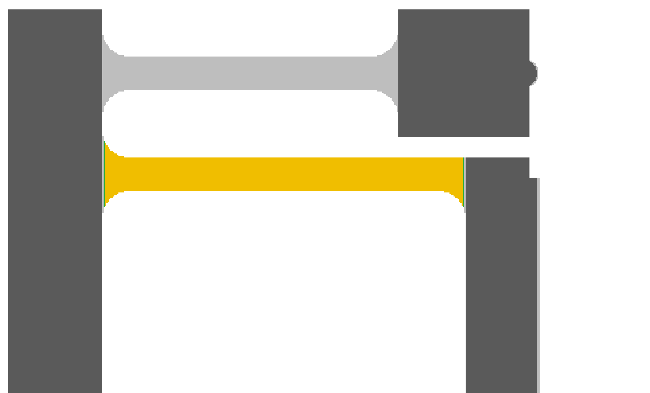
cad/review/a8/printcheck/cartridge_L_z027.4_bridge.png
