rammp-org/space-bar-push-assist/(commit log)

2026-10-24 Add round 5 push-assist handle concept (fins on a 4040 spine)
    Parametric Blender build of the printed parts: each handle is a 36 mm fin
    that caps the end of a box sitting on a horizontal 4040, with the load-cell
    head, moment-bypass sleeve, and lead routing. Bought parts are STLs exported
    from Onshape; FeatureScript sources for them are included.
    [esp32_p4.stl, hx711.stl, load_cell.stl, mtb_grip.stl, rj45_coupler.stl]
2026-10-24 Round 6: one-piece wedge unit on the Permobil Corpus back plate
    The chair is now a Corpus seat whose back is a plate of vertical 4040s
    leaning 15 deg past vertical. Drop the horizontal 4040 spine and bolt the
    bridge's front land straight to the plate with four M8 T-nuts.
    - Side section is a trapezoid wedge: level top at the grip axis, 60 deg
    rear face, front face flat on the plate for 40 mm then vertical.
    - Bridge is 92 mm tall to clear the central block; the end fins run to
    140 mm and carry the wedge. Handles stay 14 in apart.
    - Electronics lie flat on the bridge floor; leads take one R13 bend
    inboard through the end wall (check_wires.py passes).
    - Add cad/profile/profile.py, the 2D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
2026-10-27 Add README
    Covers what the push assist does, the hardware, the current round 6
    design on the Corpus back plate, the repo layout and how to run the builds.
2026-10-27 Add print plates export and assembly guide
    export_prints.py writes print-oriented STLs and 3MF plates, including a
    structure-only set for one night on an H2D and a P1S (fins standing). The
    README gets printing notes, a hardware list and step-by-step assembly.
2026-10-27 Add exploded assembly step renders to the README
    Model the fasteners (M3 and M4 countersunk screws with their nuts, M8 bolts,
    T-nuts) at their installed positions, and render four exploded steps with
    each bolt axis drawn as a line: handle, fin to tray, mounting on the plate,
    electronics.
2026-10-27 Design loop: eight design/review attempts on the push-assist unit
    Eight rounds, each designed against alex-3d-skills `cad check` and scored by an
    independent reviewer (cad-design-review). Final scores F8 / M8 / A9; full log in
    cad/review/attempts.md, every review in cad/review/a1..a8.
    - Fins 50 mm thick so the Ø50 barrel is flush (it hit the tray end wall); fins print flat.
    - Each handle's load cell sits in a printed parallel-leaf flexure cartridge, on the
    leaves' mid-height (no lean crosstalk), with overload stops on the cell axis set on
    the bench in a printed cradle (firmware/bench_scale) and a lean catch under the piston.
    - Unit hangs on six M5 caps into 40-series T-nuts; lab-kit ha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
2026-11-02 Add ESP-IDF + espp firmware for the two handle load cells
    Replace the Arduino bench sketch with an ESP-IDF + espp app for the Waveshare
    ESP32-P4-WIFI6-POE-ETH that reads both handles' load cells and serves them over
    ethernet to an HTML dashboard. firmware/README.md has wiring, build, network and
    the bench results.
    - Two SparkFun HX711 breakouts (amp 1 = left on GPIO 21/20, amp 2 = right on
    GPIO 5/4) through esp-idf-lib/hx711, wrapped in load_cell.hpp for tare, sign
    and newtons. Init waits 1 s for the first conversion: the driver's 200 ms is
    shorter than the HX711's settling at 10 S/s.
    - Ethernet via espp::Ethernet with the board's RMII pins (not the BSP singleton,
    which grabs GPIO 7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
    [partitions.csv]
2026-11-02 Add the MIB input-device guide and point the docs at the firmware
    docs/MIB-INPUT-DEVICES.md sets the rule for every input device: devices publish
    what they measure, the MIB turns it into forward and turn targets for its
    trajectory planner. It walks through how the MIB drives today (stick and
    TwistSetpoint into DriveController and espp::TrajectoryPlanner, checked against
    RAMMP-mib-fw 7021c38), a checklist for adding a device, and the push-assist
    case: a proposed HandleForce message, the PUSH_ASSIST state already in
    rammp-rtps, the reference push_to_twist() conversion with starting gains, the
    stop conditions, and what is left in each repo.
    - The dashboard runs the same conversion live (pushTo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
2026-11-02 Document the push-assist board's network interface
    firmware/INTERFACE.md is what the MIB, the MIB control panel and the
    dashboard build against: board and network, the service stream on tcp :5555
    (telemetry module 3, push_assist module 0x30, discovery), the PUSH? reply on
    udp :5556, the telemetry channels with units, and the device and MIB
    parameters. It also records the OTA and self-describing params spec agreed
    with the MIB control-panel session, marked as not built yet.
2026-11-02 Add OTA, runtime params and the RTPS HandleForce publisher to the firmware
    The board now does what the MIB control panel and the MIB need from it
    (firmware/INTERFACE.md, agreed with the panel session):
    - RTPS: rammp::HandleForce on rammp/push_assist/handle_force, one sample per
    conversion: both forces in N, health flags (amp ok, zero tracking at its
    cap, OTA running) and a sequence number. The message comes from rammp-rtps
    PR #23, pinned as the external/rammp-rtps submodule. The participant starts
    once the board has an IP and restarts on a new lease.
    - OTA: espp OtaService on module 0, with PACE RACER's rollback gate (a new
    image confirms itself after a lease and 20 s of service;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
2026-11-02 Point the docs at the MIB's push-assist gains and panel (RAMMP-mib-fw #65)
    INTERFACE.md lists the MIB-side keys and the files behind them;
    MIB-INPUT-DEVICES.md moves the gains, push_to_twist() and the panel link
    to done and leaves the PUSH_ASSIST state, the HandleForce subscriber and
    the stops for the MIB.
2026-11-02 Record the push-assist bench test on the chair network
    Params through NVS, HandleForce received by an independent DDS reader
    (0 missing), and OTA over ethernet with both the self-confirm gate and the
    rollback, all on the board. INTERFACE.md also warns, from what happened
    today, against putting the bench (DHCP server) build on the chair network.
2026-11-02 Swap the push-assist handles' pins: left is GPIO 4/5, right is 20/21
    On the chair, the amp on GPIO 20/21 is on the right handle. The Kconfig
    defaults, docs and mock now say left = CLK 5 / DAT 4 and right = CLK 21 /
    DAT 20. Both cells also read negative on a push there, so the board's saved
    params invert both; the Kconfig invert defaults stay off. Flashed to the
    board over ethernet and confirmed: pins swapped, inversions kept from NVS,
    HandleForce publishing.
    [mock_board.py]
2026-11-10 Add a touch switch and touch tare to each push-assist handle
    A capacitive pad in each grip (left GPIO 3, right GPIO 2) gates the handle
    force: untouched the handle sends 0 N, and on each touch its zero becomes the
    mean force over the 1 s ending 0.2 s before the touch. On the bench a handle
    kept +6 to +10 N after every push (+13.9 N at most) with hands off; replayed
    through TouchGate that log sends 0.00 N hands-off over 12 touches.
    - main/touch_probe.hpp: both pads on ESP-IDF's esp_driver_touch_sens.
    - main/touch_gate.hpp: own idle baseline, on/off hysteresis per handle,
    the pre-touch tare, and recovery from a pad stuck high with no force.
    The sensor's own benchmark froze when a probe wa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
    [main.cpp, mock_board.py, touch_gate.hpp, touch_probe.hpp, usb_board.py]
